Spelieye/Amp-Reverb-Control/README.md

# Amp-Reverb-Control
Ever wish that you could control your amplifier's reverb effect on the fly without major modification to your amplifier? Well now your wish can become a reality! 

This is a reverb control platform that can be placed into an amplifier and has a remote pedal that controls the reverb effect. 

It has two parts: the master mcu unit that goes into the amplifier and a slave mcu unit in a pedal. You replace the reverb pot in the amplifier with the digital one on the PCB so the audio signal stays inside of the amplifier. The existing reverb pot -- if it is a 100kA pot-- connects to the master mcu board to control the reverb locally if the pedal is not plugged in. 
Connect the master mcu to the pedal mcu via a 6 pin GX12 cable and you are now able to remotely control the reverb. You can select between two different levels and turn the effect on or off. 

## The Build

The mcu on both boards is an Atmel ATtiny26L. The PCB boards were designed to be easy to install into an amplifier and a pedal. 

### AMP PCB

PCB of the Master MCU 

### Pedal PCB 

Screenshot 2026-06-22 at 11 38 00 AM


### Pedal Assembly
Screenshot 2026-06-11 at 2 40 46 PM
Screenshot 2026-06-11 at 2 40 34 PM

### Full photo of the master mcu installed in the amp


### Close up of the master MCU showing the audio signal path. Red is input to the digital pot and blue is output of the digital pot. 
IMG_2324 copy

### Real pics of pedal


## Schematic for connecting the master MCU 

### Signal Connection
Screenshot 2026-10-20 at 3 49 12 PM

### Power Connection
Screenshot 2026-10-20 at 3 49 44 PM

The 6 pin comms header connects to "Slave_MCU" header on both boards. 

## Flashing 

To flash the mcus be sure to use the correct `.hex` file for the associated board. Connect your flasher to the ISP header. 

First update the fuses

```
avrdude -c usbtiny -p t26 -U lfuse:w:0xc4:m -U hfuse:w:0xf6:m
```

Flashing the master board
```
avrdude -c usbtiny -p t26 -U flash:w:amp_master_rev1.hex
```

Flashing the pedal board 
```
avrdude -c usbtiny -p t26 -U flash:w:pedal_slave_rev1.hex
```
## Video of Pedal Demo
Here
