Spelieye/Amp-Reverb-Control/Amp_Master/PCB/Amp_Master_Schematic_rev1.pdf

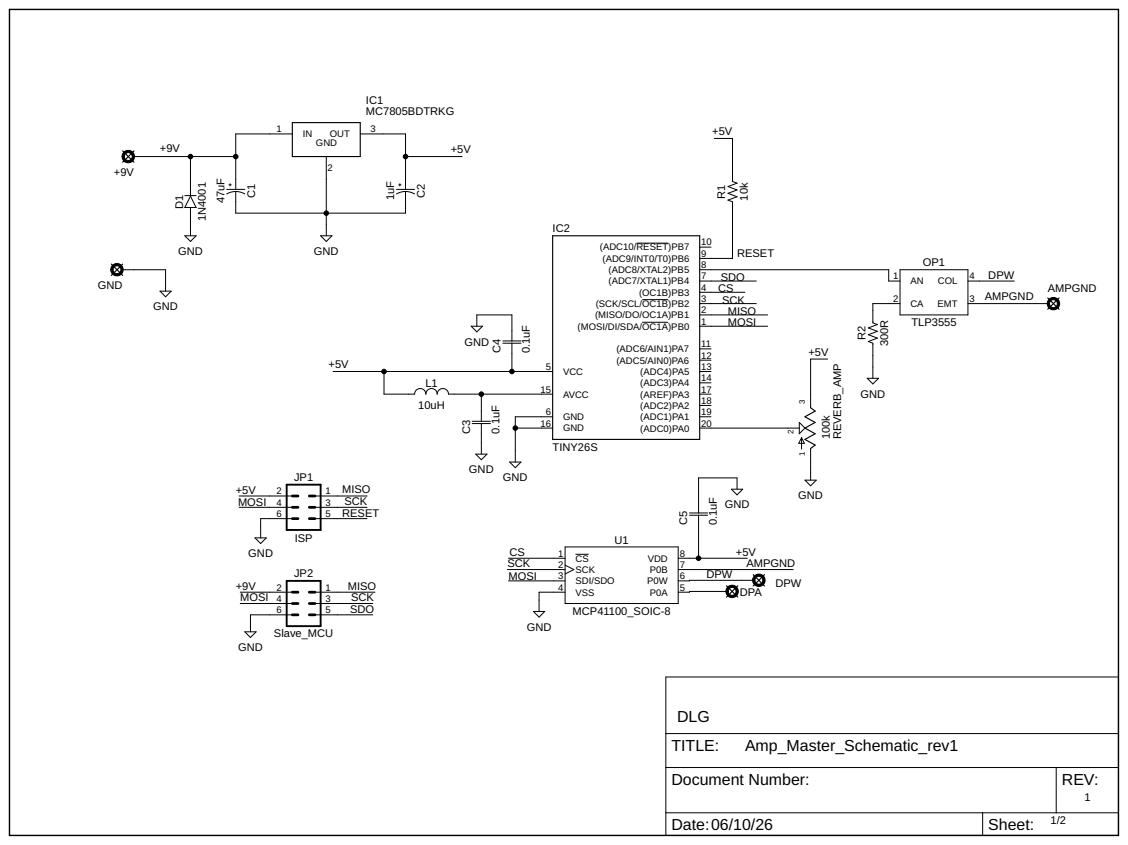
[picture p1: page 1]

Document Number: | REV: 1

Date: 06/10/26 | Sheet: 1/2
