Spelieye/Amp-Reverb-Control/Pedal/PCB/Slave_Pedal_Schematic_rev1.pdf

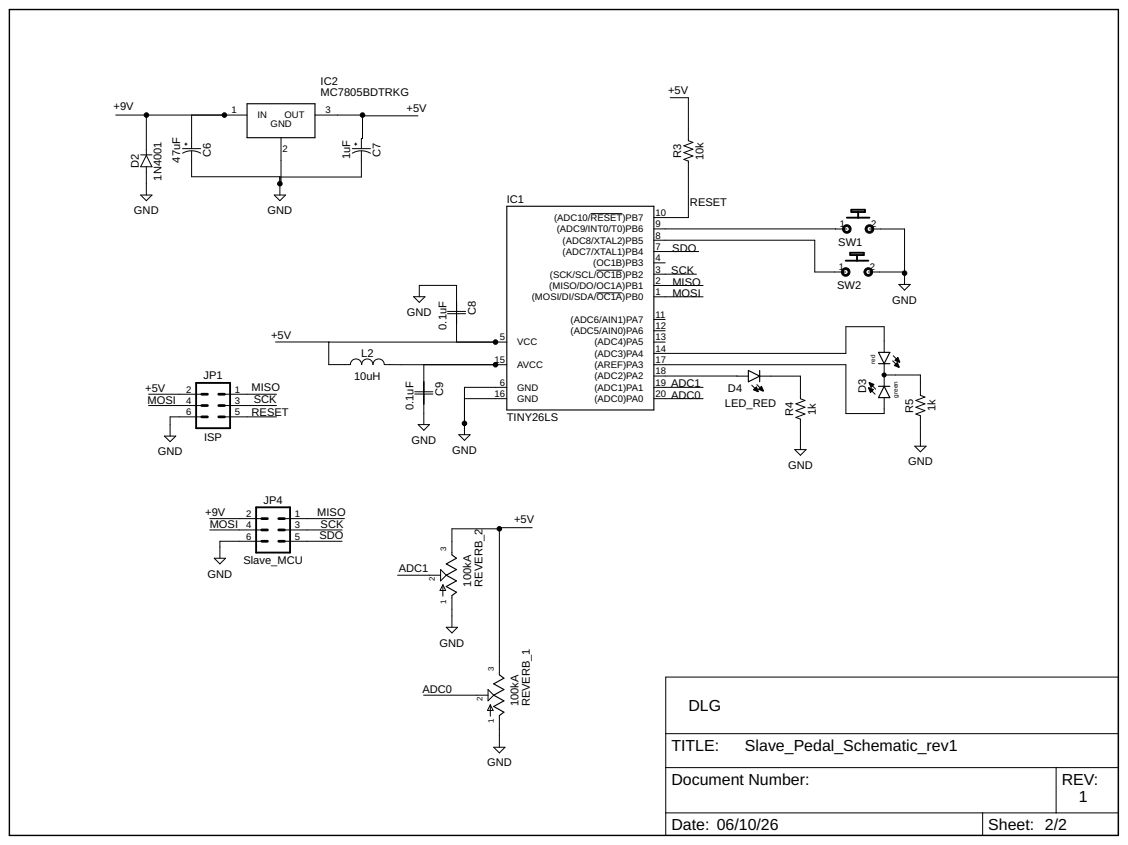
[picture p2: page 1]

Document Number: | REV: 1

Date: 06/10/26 | Sheet: 2/2
