Spelieye/Amp-Reverb-Control/Pedal/PCB/Slave_Pedal_PCB_rev1.brd

## EAGLE design Pedal/PCB/Slave_Pedal_PCB_rev1.brd (2026-10-21)

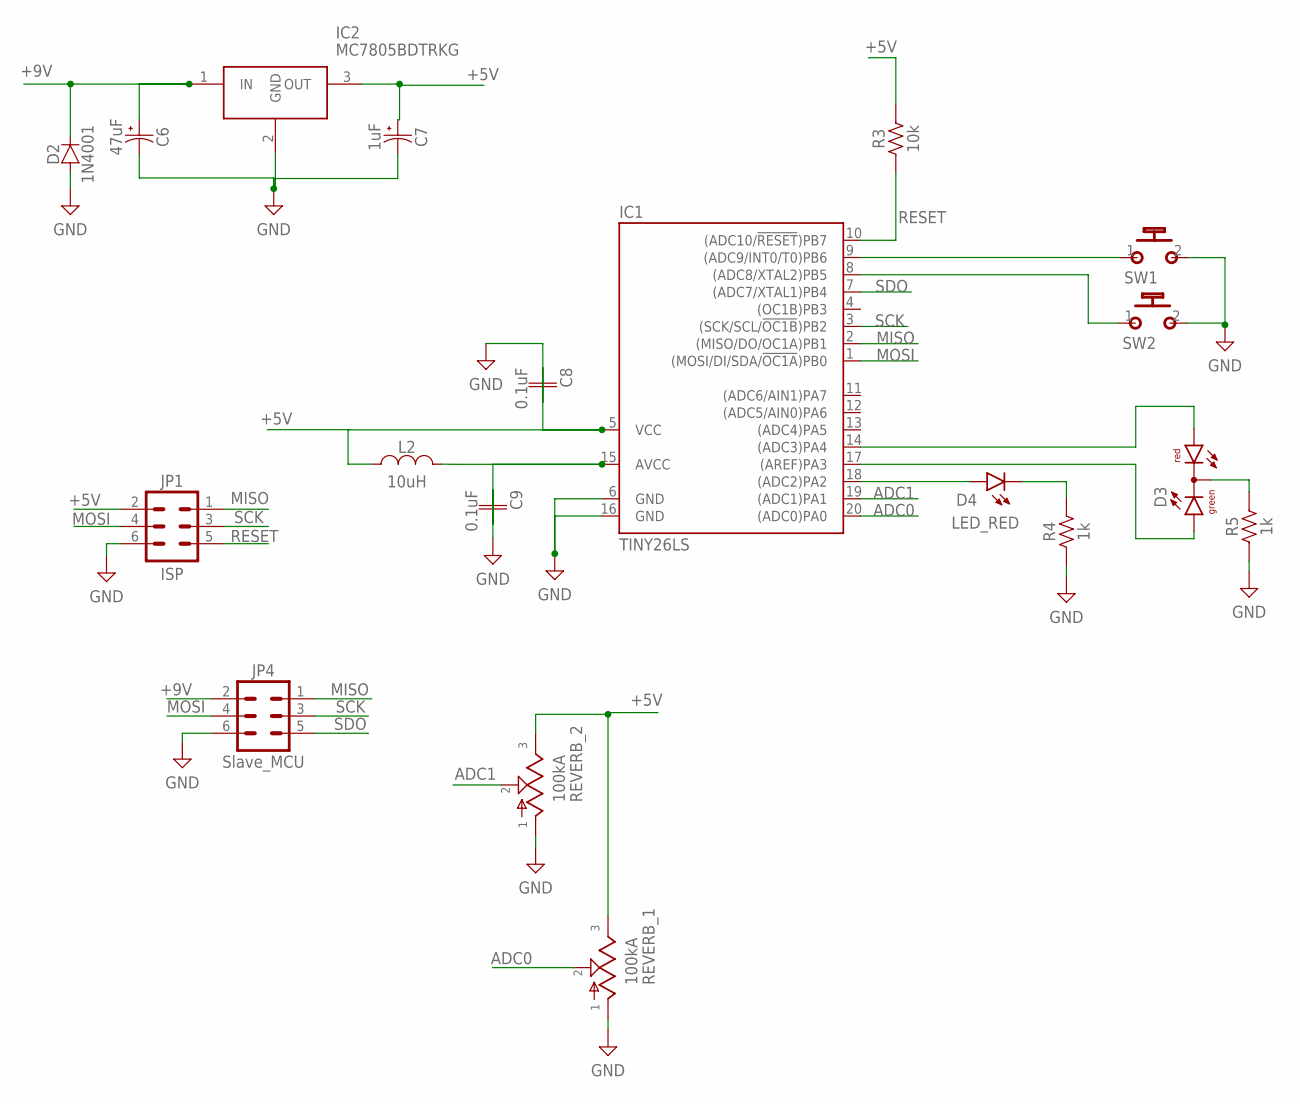
[picture p3: schematic Slave_Pedal_Schematic_rev1.sch]

Parts:
C6: 47uF; CAPAE430X430N
C7: 1uF; CAPAE430X430N
C8, C9: 0.1uF; CAPC3216X135
D2: 1N4001; DIOM5226X290N
D3: DUOLED5MMRGLED_LIFTED; DUOLED-C-5MM
D4: LED_RED; LEDRD254W60D565H860B
IC1: TINY26LS; SO20L
IC2: MC7805BDTRKG; LM317MADTRKG
JP1: ISP; 2X3-SHROUDED
JP4: Slave_MCU; 2X3-SHROUDED
L2: 10uH; INDC3216X190
R3: 10k; RESC3216X70
R4, R5: 1k; RESC3216X70
REVERB_1, REVERB_2: 100kA; 16MM
SW1, SW2: MOMENTARYJST; B2B-XH-A

Connections:
+5V: C7.1 (+), C8.1, IC1.5 (VCC), IC2.3 (OUT), JP1.2, L2.1, R3.2, REVERB_1.3, REVERB_2.3
+9V: C6.1 (+), D2.1 (C), IC2.1 (IN), JP4.2
ADC0: IC1.20 ((ADC0)PA0), REVERB_1.2
ADC1: IC1.19 ((ADC1)PA1), REVERB_2.2
GND: C6.2 (-), C7.2 (-), C8.2, C9.1, D2.2 (A), IC1.6 (GND), IC1.16 (GND), IC2.2 (GND), JP1.6, JP4.6, R4.1, R5.1, REVERB_1.1, REVERB_2.1, SW1.2 (S), SW2.2 (S)
MISO: IC1.2 ((MISO/DO/OC1A)PB1), JP1.1, JP4.1
MOSI: IC1.1 ((MOSI/DI/SDA/!OC1A!)PB0), JP1.4, JP4.4
unnamed: IC1.9 ((ADC9/INT0/T0)PB6), SW1.1
unnamed: IC1.8 ((ADC8/XTAL2)PB5), SW2.1
unnamed: D3.AR, IC1.14 ((ADC3)PA4)
unnamed: D4.1 (A), IC1.18 ((ADC2)PA2)
unnamed: D3.AX (AG), IC1.17 ((AREF)PA3)
unnamed: C9.2, IC1.15 (AVCC), L2.2
unnamed: D4.2 (C), R4.2
unnamed: D3.C, R5.2
RESET: IC1.10 ((ADC10/!RESET!)PB7), JP1.5, R3.1
SCK: IC1.3 ((SCK/SCL/!OC1B!)PB2), JP1.3, JP4.3
SDO: IC1.7 ((ADC7/XTAL1)PB4), JP4.5

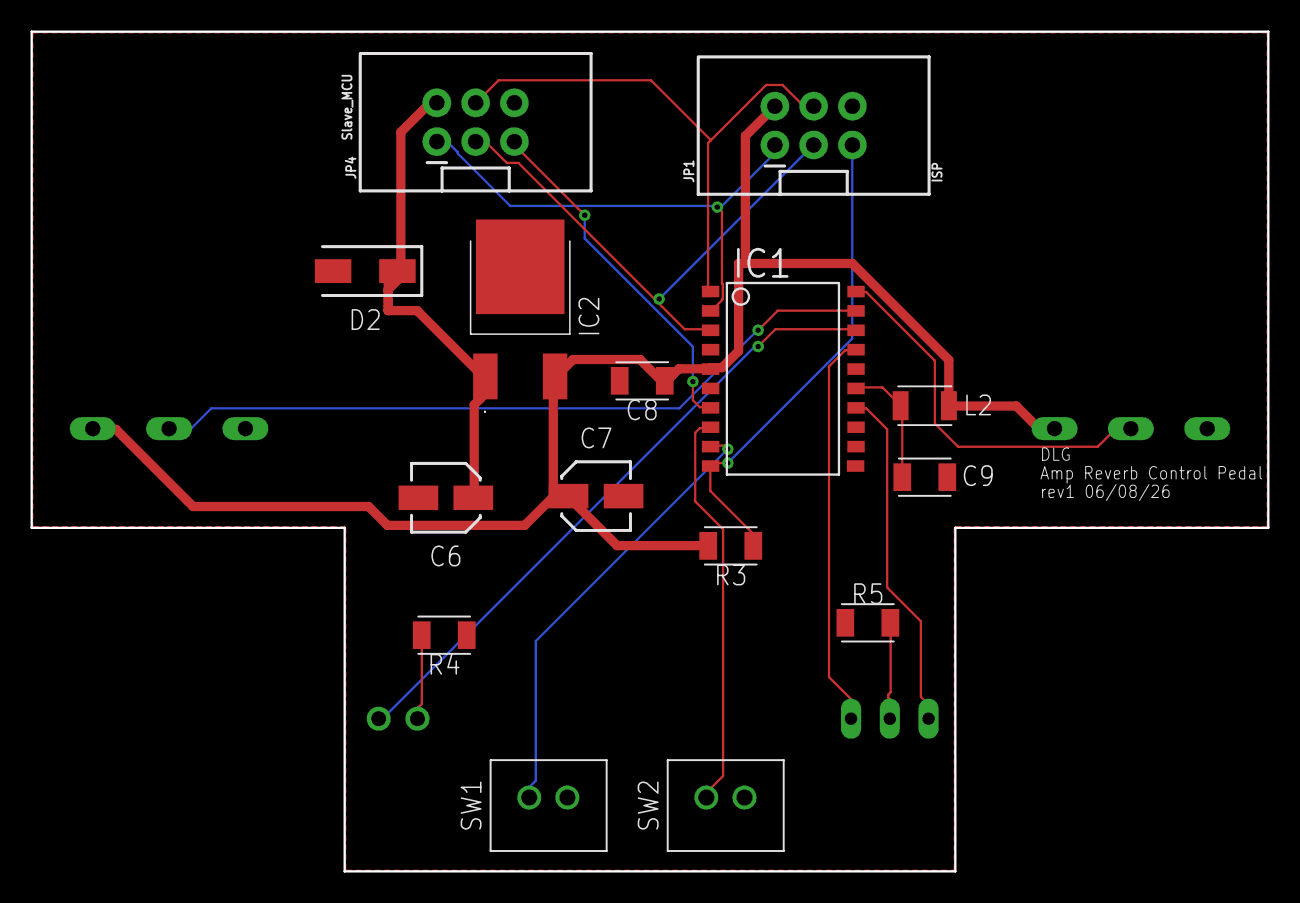
[picture p4: board Slave_Pedal_PCB_rev1.brd from above]

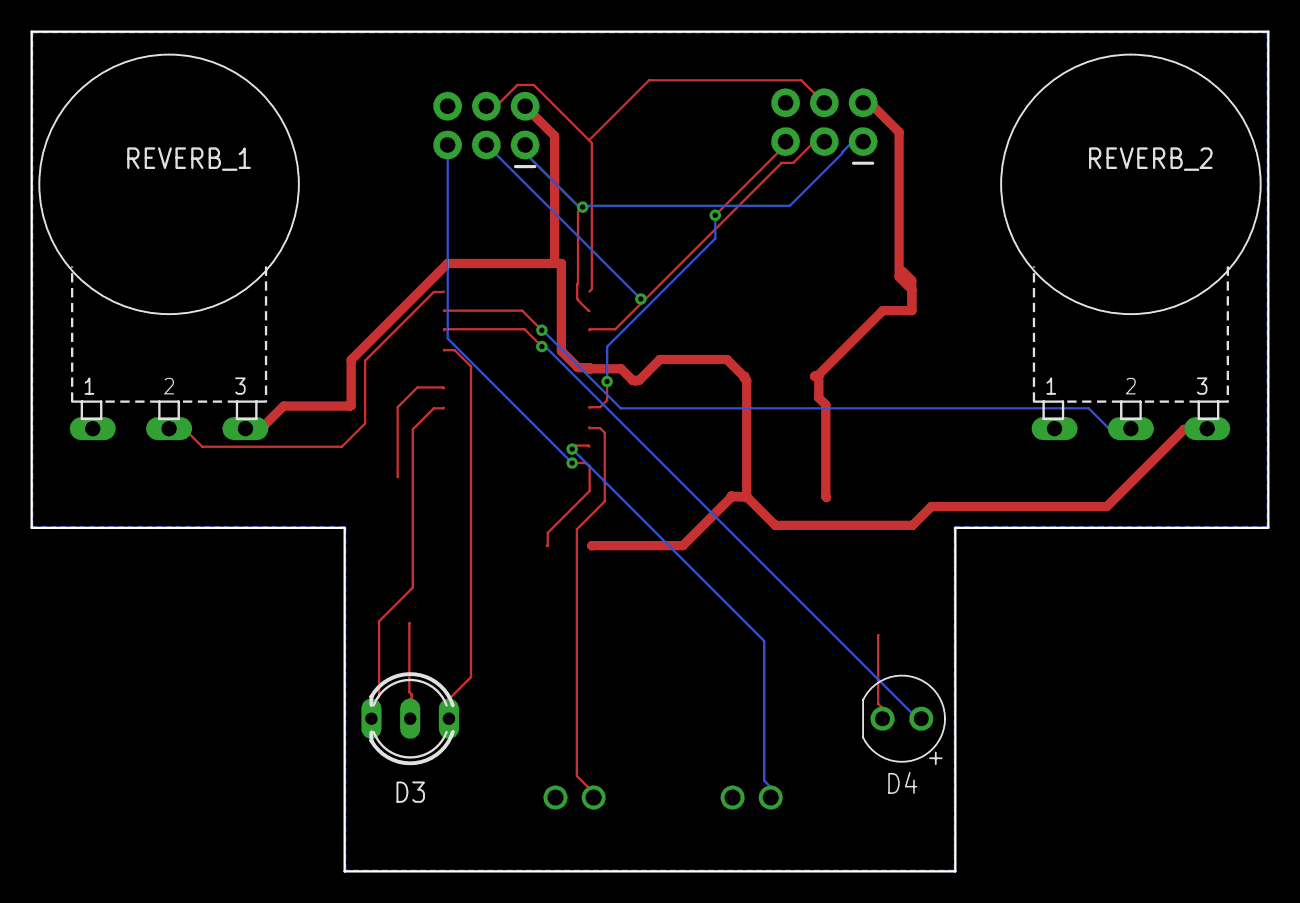
[picture p5: board Slave_Pedal_PCB_rev1.brd from below]

Board: 2 copper layers, 81.0 x 55.0 mm, 19 parts (4 on the bottom side), 18 nets.
