Spelieye/Amp-Reverb-Control/Amp_Master/PCB/Amp_Master_PCB_rev1.brd

## EAGLE design Amp_Master/PCB/Amp_Master_PCB_rev1.brd (2026-10-21)

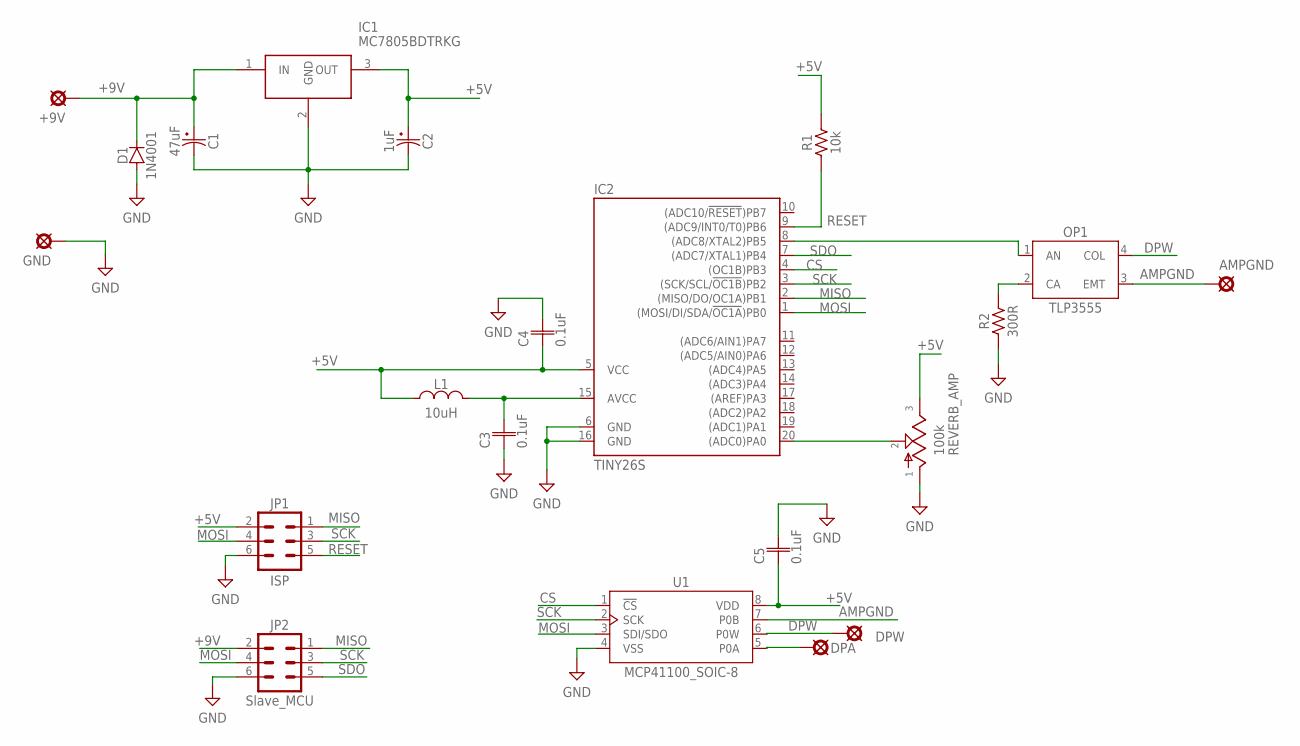
[picture p6: schematic Amp_Master_Schematic_rev1.sch]

Parts:
+9V: PADSQUARE_20AWG; SQUARE_0.813MM
AMPGND: PADSQUARE_20AWG; SQUARE_0.813MM
C1: 47uF; CAPAE430X430N
C2: 1uF; CAPAE430X430N
C3, C4, C5: 0.1uF; CAPC3216X135
D1: 1N4001; DIOM5226X290N
DPA: PADSQUARE_20AWG; SQUARE_0.813MM
DPW: PADSQUARE_20AWG; SQUARE_0.813MM
GND: PADSQUARE_20AWG; SQUARE_0.813MM
IC1: MC7805BDTRKG; LM317MADTRKG
IC2: TINY26S; SO20L
JP1: ISP; 2X3-SHROUDED
JP2: Slave_MCU; 2X3-SHROUDED
L1: 10uH; INDC3216X190
OP1: TLP3555; DIP4
R1: 10k; RESC3216X70
R2: 300R; RESC3216X70
REVERB_AMP: 100k; 16MM-PCB-MOUNT
U1: MCP41100_SOIC-8; SOIC127P600X175-8N

Connections:
+5V: C2.1 (+), C4.1, C5.1, IC1.3 (OUT), IC2.5 (VCC), JP1.2, L1.1, R1.2, REVERB_AMP.3, U1.8 (VDD)
+5V1: C3.2, IC2.15 (AVCC), L1.2
+9V: +9V.1, C1.1 (+), D1.1 (C), IC1.1 (IN), JP2.2
AMPGND: AMPGND.1, OP1.3 (EMT), U1.7 (P0B)
CS: IC2.4 ((OC1B)PB3), U1.1 (!CS)
DPW: DPW.1, OP1.4 (COL), U1.6 (P0W)
GND: C1.2 (-), C2.2 (-), C3.1, C4.2, C5.2, D1.2 (A), GND.1, IC1.2 (GND), IC2.6 (GND), IC2.16 (GND), JP1.6, JP2.6, R2.1, REVERB_AMP.1, U1.4 (VSS)
MISO: IC2.2 ((MISO/DO/OC1A)PB1), JP1.1, JP2.1
MOSI: IC2.1 ((MOSI/DI/SDA/!OC1A!)PB0), JP1.4, JP2.4, U1.3 (SDI/SDO)
unnamed: IC2.20 ((ADC0)PA0), REVERB_AMP.2
unnamed: IC2.8 ((ADC8/XTAL2)PB5), OP1.1 (AN)
unnamed: OP1.2 (CA), R2.2
unnamed: DPA.1, U1.5 (P0A)
RESET: IC2.9 ((ADC9/INT0/T0)PB6), JP1.5, R1.1
SCK: IC2.3 ((SCK/SCL/!OC1B!)PB2), JP1.3, JP2.3, U1.2 (SCK)
SDO: IC2.7 ((ADC7/XTAL1)PB4), JP2.5

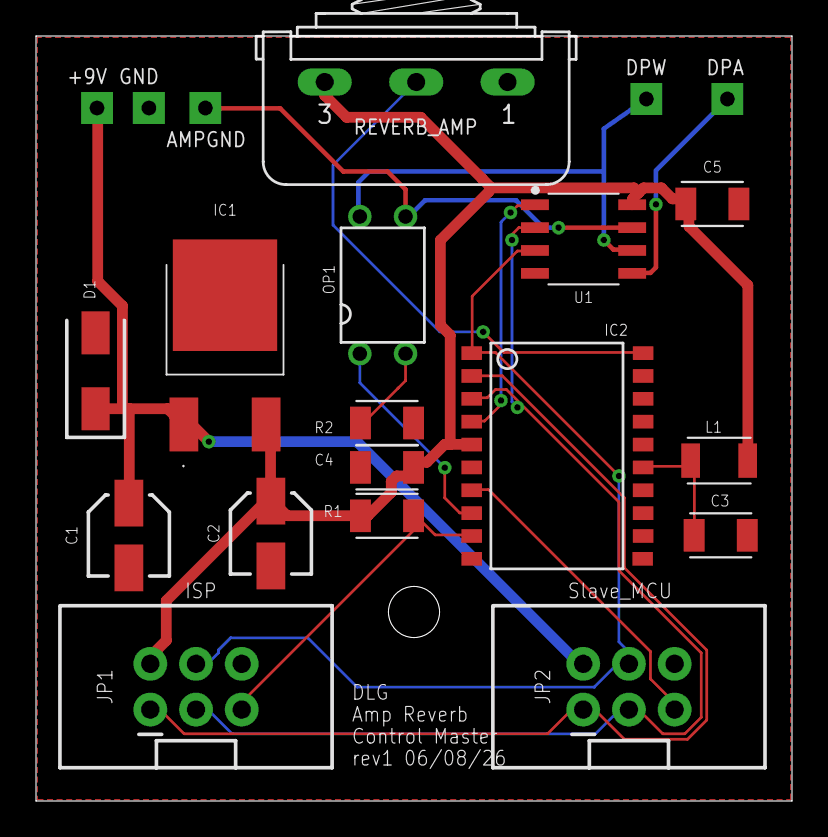
[picture p7: board Amp_Master_PCB_rev1.brd from above]

Board: 2 copper layers, 42.0 x 42.5 mm, 21 parts (0 on the bottom side), 16 nets.
